Roman3349/led-controller-v2/docs/img/schema.pdf

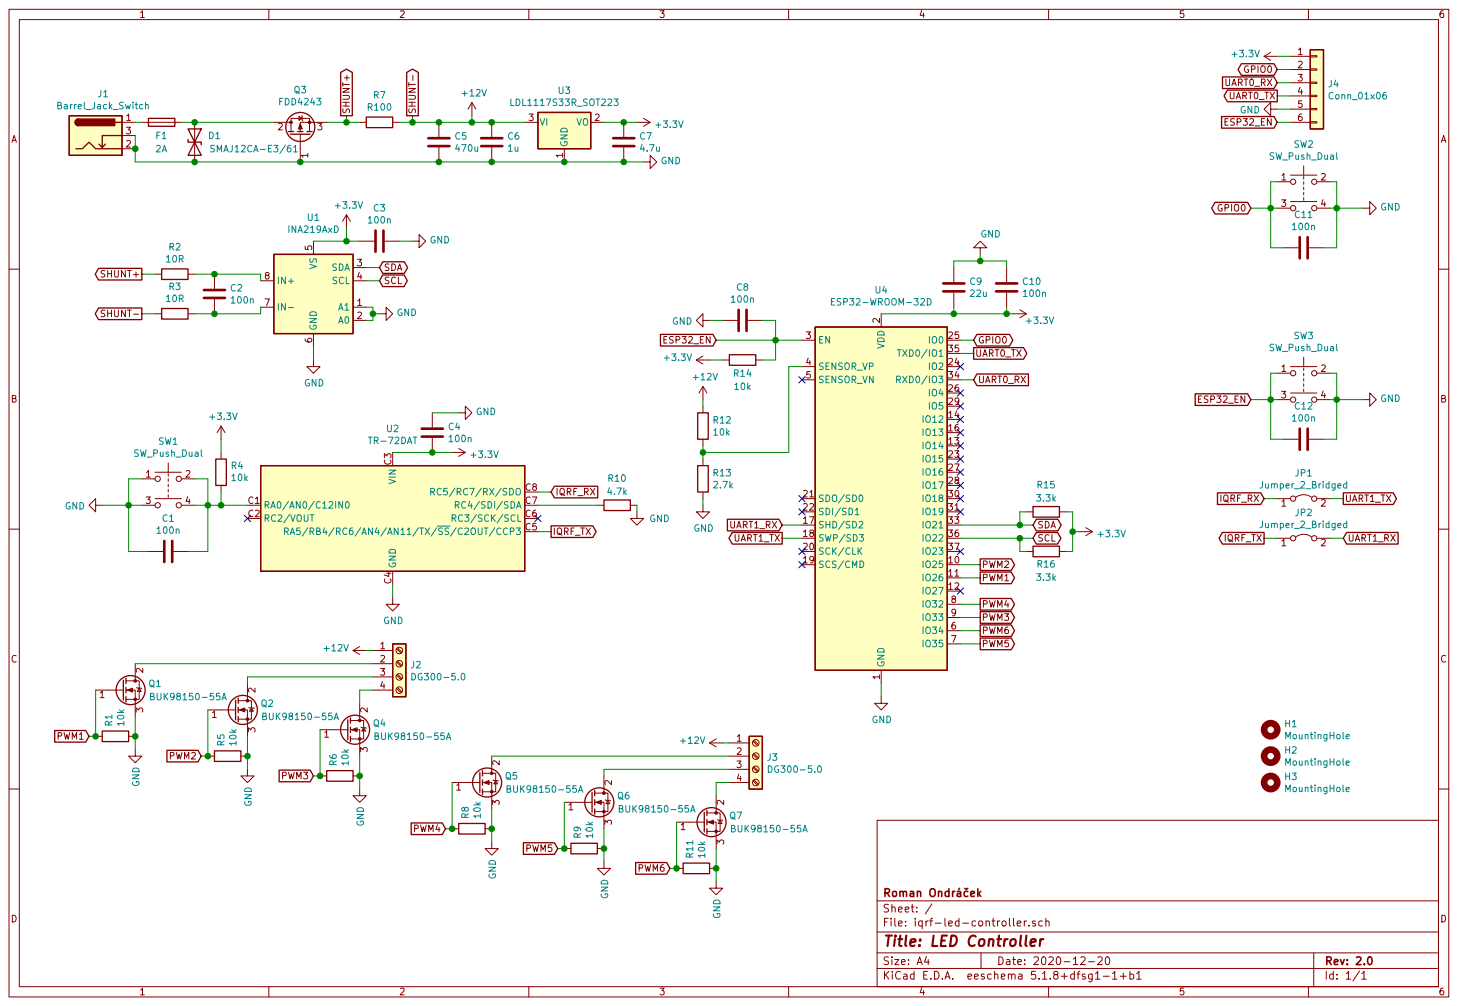
[picture p7: page 1]

2 SCK/CLK 20 SDO/SD0 21 SDI/SD1 22

File: iqrf-led-controller.sch Sheet: / Roman Ondráek

Id: 1/1 Title: LED Controller
