Roman3349/led-controller-v2/hw/iqrf-led-controller.kicad_pcb

## KiCad design hw/iqrf-led-controller.kicad_pcb (2020-12-20)

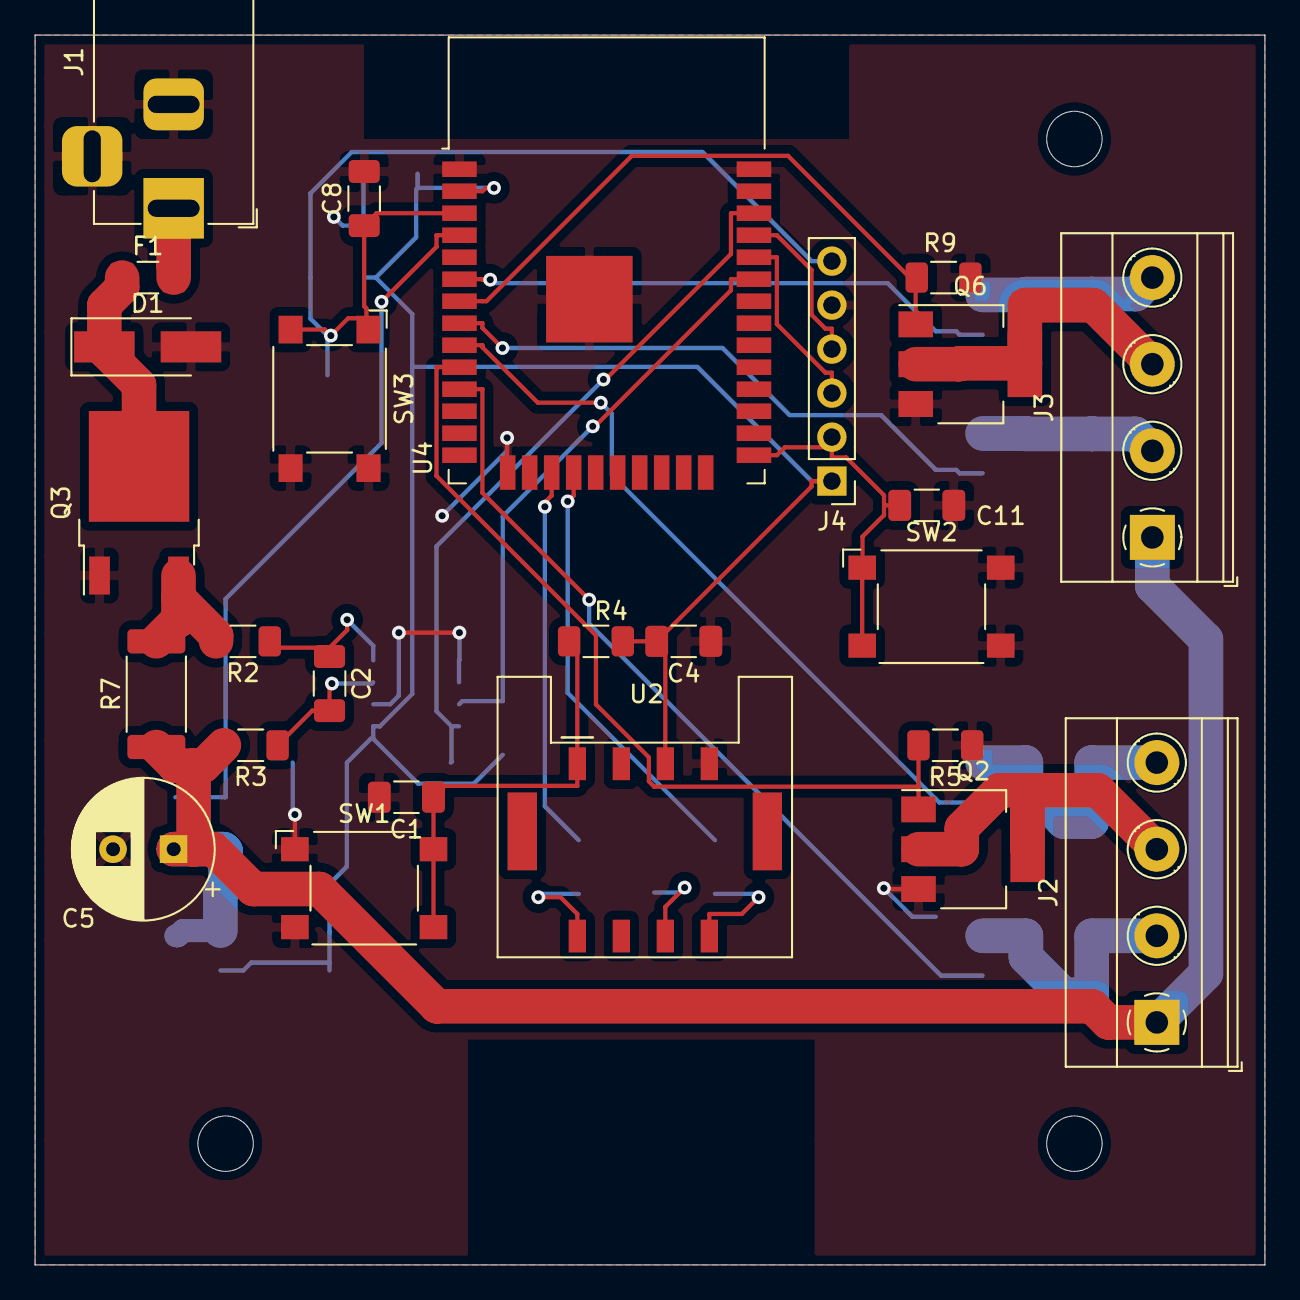
[picture p8: board iqrf-led-controller.kicad_pcb from above]

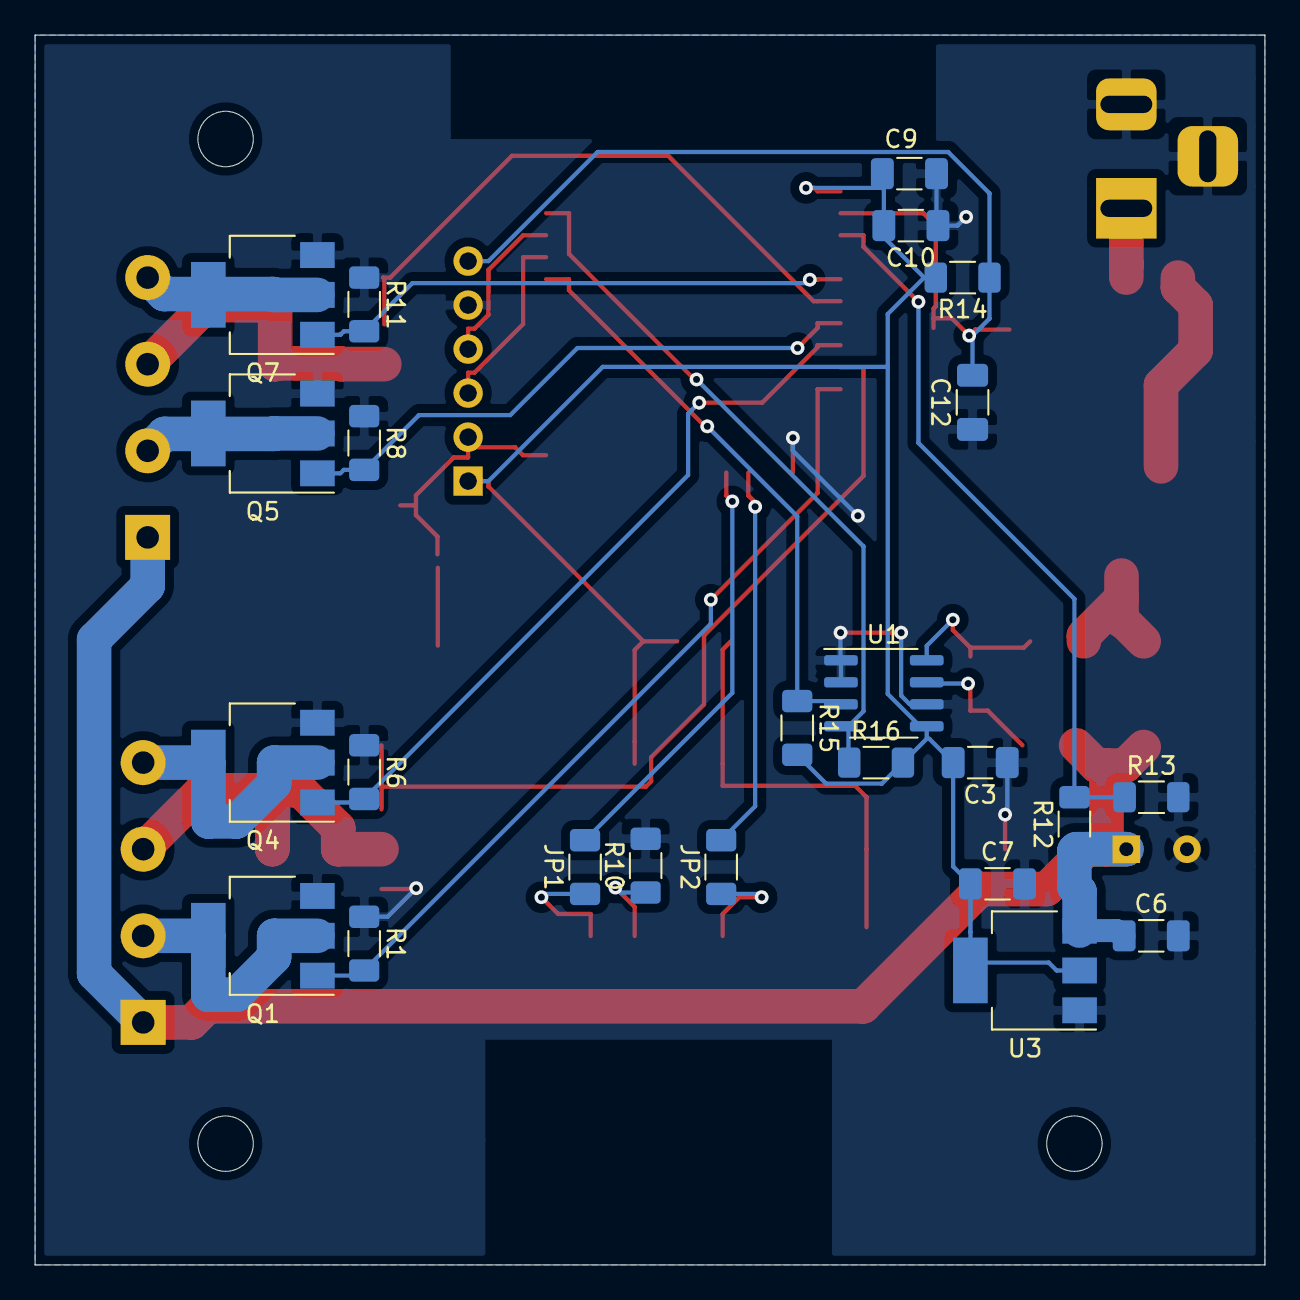
[picture p9: board iqrf-led-controller.kicad_pcb from below]

Board: 2 copper layers, 71.0 x 71.0 mm, 53 parts (24 on the bottom side), 33 nets.

Parts:
C1, C2, C3, C4, C8, C10, C11, C12: 100n; C_1206_3216Metric_Pad1.33x1.80mm_HandSolder
C5: 470u; CP_Radial_D8.0mm_P3.50mm
C6: 1u; C_1206_3216Metric_Pad1.33x1.80mm_HandSolder
C7: 4.7u; C_1206_3216Metric_Pad1.33x1.80mm_HandSolder
C9: 22u; C_1206_3216Metric_Pad1.33x1.80mm_HandSolder
D1: SMAJ12CA-E3/61; D_SMA_Handsoldering
F1: 2A; Fuse_1206_3216Metric_Pad1.42x1.75mm_HandSolder
H1, H2, H3: MountingHole; MountingHole_3.2mm_M3
J1: Barrel_Jack_Switch; BarrelJack_Horizontal
J2, J3: DG300-5.0; TerminalBlock_Phoenix_MKDS-1,5-4_1x04_P5.00mm_Horizontal
J4: Conn_01x06; PinHeader_1x06_P2.54mm_Vertical
JP1, JP2: Jumper_2_Bridged; R_1206_3216Metric_Pad1.30x1.75mm_HandSolder
Q1, Q2, Q4, Q5, Q6, Q7: BUK98150-55A; SOT-223-3_TabPin2
Q3: FDD4243; TO-252-2
R1, R4, R5, R6, R8, R9, R11, R12, R14: 10k; R_1206_3216Metric_Pad1.30x1.75mm_HandSolder
R2, R3: 10R; R_1206_3216Metric_Pad1.30x1.75mm_HandSolder
R7: R100; R_2512_6332Metric_Pad1.40x3.35mm_HandSolder
R10: 4.7k; R_1206_3216Metric_Pad1.30x1.75mm_HandSolder
R13: 2.7k; R_1206_3216Metric_Pad1.30x1.75mm_HandSolder
R15, R16: 3.3k; R_1206_3216Metric_Pad1.30x1.75mm_HandSolder
SW1, SW2, SW3: SW_Push_Dual; SW_SPST_Omron_B3FS-100xP
U1: INA219AxD; SOIC-8_3.9x4.9mm_P1.27mm
U2: TR-72DAT; IQRF_TRx2DA_KON-SIM-01
U3: LDL1117S33R_SOT223; SOT-223-3_TabPin2
U4: ESP32-WROOM-32D; ESP32-WROOM-32

Connections:
+3V3: C3.2, C4.2, C7.1, C9.2, C10.2, J4.1, R4.2, R14.2, R15.2, R16.2, U1.5, U2.C3, U3.2, U4.2
ESP32_EN: C8.1, C12.2, J4.6, R14.1, SW3.1, SW3.3, U4.3
GND: C1.2, C3.1, C4.1, C5.2, C6.2, C7.2, C8.2, C9.1, C10.1, C11.1, C12.1, D1.2, J1.2, J1.3, J4.5, Q1.3, Q2.3, Q3.1, Q4.3, Q5.3, Q6.3, Q7.3, R1.1, R5.1, R6.1, R8.1, R9.1, R10.2, R11.1, R13.2, SW1.1, SW1.3, SW2.2, SW2.4, SW3.2, SW3.4, U1.1, U1.2, U1.6, U2.C4, U3.1, U4.1, U4.15, U4.38, U4.39
GPIO0: C11.2, J4.2, SW2.1, SW2.3, U4.25
IQRF_RX: JP1.1, U2.C8
IQRF_TX: JP2.1, U2.C5
unnamed: C1.1, R4.1, SW1.2, SW1.4, U2.C1
unnamed: C2.1, R2.1, U1.8
unnamed: C2.2, R3.1, U1.7
unnamed: D1.1, F1.1, Q3.2
unnamed: F1.2, J1.1
unnamed: J2.2, Q1.2
unnamed: J2.3, Q2.2
unnamed: J2.4, Q4.2
unnamed: J3.2, Q5.2
unnamed: J3.3, Q6.2
unnamed: J3.4, Q7.2
unnamed: R10.1, U2.C7
unnamed: R12.2, R13.1, U4.4
PWM1: Q1.1, R1.2, U4.11
PWM2: Q2.1, R5.2, U4.10
PWM3: Q4.1, R6.2, U4.9
PWM4: Q5.1, R8.2, U4.8
PWM5: Q6.1, R9.2, U4.7
PWM6: Q7.1, R11.2, U4.6
SCL: R16.1, U1.4, U4.36
SDA: R15.1, U1.3, U4.33
SHUNT+: Q3.3, R2.2, R7.2
SHUNT-: C5.1, C6.1, J2.1, J3.1, R3.2, R7.1, R12.1, U3.3
UART0_RX: J4.3, U4.34
UART0_TX: J4.4, U4.35
UART1_RX: JP2.2, U4.17
UART1_TX: JP1.2, U4.18
