Roman3349/led-controller-v2/(commit log)

2020-12-20 ESP32: add basic UART functionality
2020-12-20 HW: add KiCAD project
    [iqrf-led-controller.kicad_pcb, iqrf-led-controller.sch]
2020-12-26 ESP32: implement GATT services and characteristics for device info and lights
2020-12-26 ESP32: fix GATTS services
    [ble_gatts_srv.c]
2020-12-27 ESP32: add INA219
2020-12-27 IQRF: add IQRF Standard Sensors
2020-12-28 ESP32: improve IQRF component
2020-12-28 ESP32: fix formats
